synthetos/gQuintic-TemperatureAdapter/README.md

# gQuintic-TemperatureAdapter
Thermistor and PT100 resistance temperature device adapter for gQuintic boards and similar
