synthetos/gQuintic-TemperatureAdapter/ProjectOtherFiles/pt100-noninverting.png

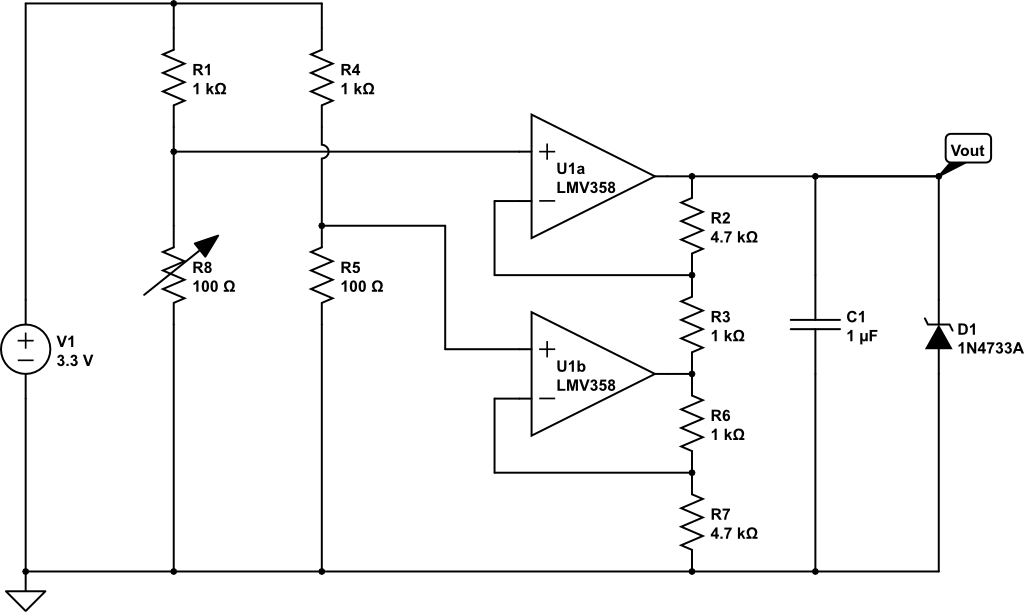
ProjectOtherFiles/pt100-noninverting.png
