synthetos/gQuintic-TemperatureAdapter/(commit log)

2018-07-03 Initial setup complete
    [TemperatureAdapter.kicad_pcb, TemperatureAdapter.sch]
2018-07-03 Imported LoadCellAdapter to start project
    [TemperatureAdapter-Main.sch, TemperatureAdapter.kicad_pcb, TemperatureAdapter.sch]
2018-07-03 First fully routed. Still needs bottom silk for assembly and type checkbox
    [TemperatureAdapter-Main.sch, TemperatureAdapter.kicad_pcb]
2018-07-03 Final before generating project outputs
    [TemperatureAdapter-Main.sch, TemperatureAdapter.kicad_pcb]
2018-07-03 Project outputs generated to OSHpark
    [TemperatureAdapter-B.Cu.gbr, TemperatureAdapter-B.Mask.gbr, TemperatureAdapter-B.Paste.gbr, TemperatureAdapter-B.SilkS.gbr, TemperatureAdapter-Edge.Cuts.gbr, TemperatureAdapter-F.Cu.gbr, TemperatureAdapter-F.Mask.gbr, TemperatureAdapter-F.Paste.gbr]
